ABoK4Do/blinchiki/3d печать/readme.txt

размеры 150x80x70(максимальные) leg 2 раза напечатать
