ABoK4Do/blinchiki/Финальная презентация.pptx

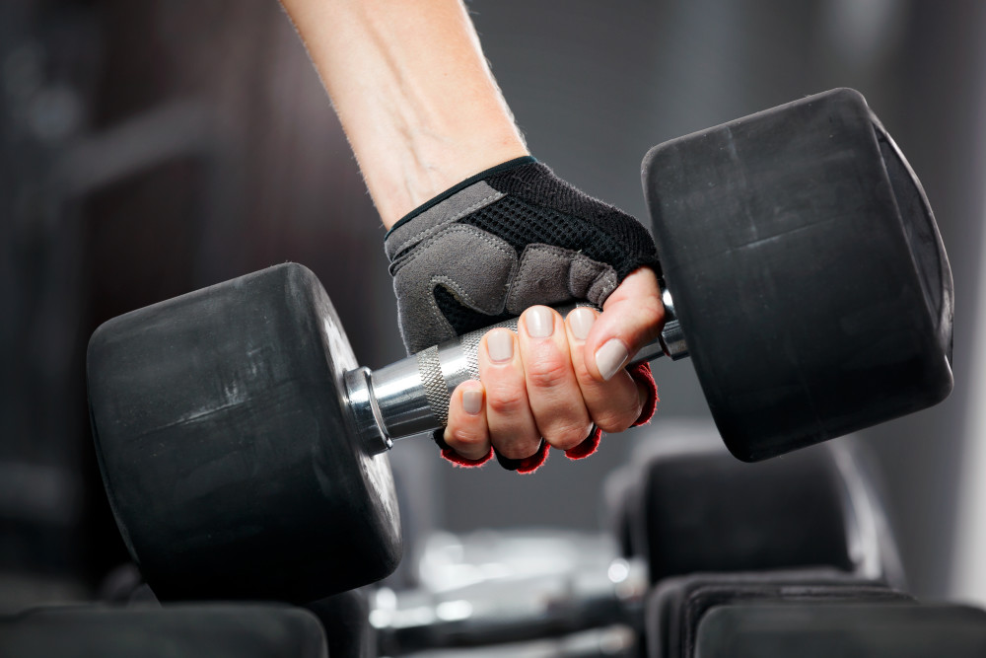
[picture p1: figure]

Brain For Barbell

## Slide 2

Резюме

Устройство

Процесс создания

Тестирование

Решением является вспомогательное устройство для гантели
Преимущества устройства включают в себя:
Контроль правильности выполнения упражнений при тренировках
Отслеживание прогресса с мобильных устройств
Сравнительно невысокая цена
Вэб интерфейс для повсеместного доступа к статистике

Определение правильности выполнения упражнение может нести вспомогательную пользу
- Повышение мотивации
- Понижение «порога входа» в спорт для людей, которым по тем или иным причинам не подходит зал

Стоит отметить, что устройство имеет как офлайн, так и онлайн функционал

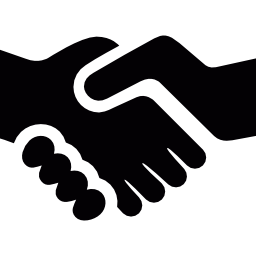
[picture p2: figure]
Hand shake
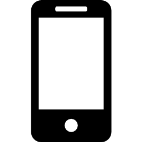
[picture p3: figure]
Cell phone
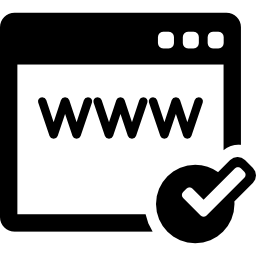
[picture p4: figure]
Domain Registration
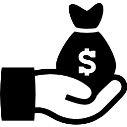
[picture p5: figure]
Dollars money bag on a hand
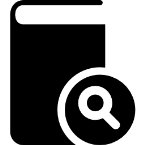
[picture p6: figure]
Book of black cover closed with a magnifier symbol on top

1. Отсчет повторов
2. Оценка результатов
3. Индикация ошибок

1. Отслеживание прогресса
2. Сравнение результатов, с иными пользователями

## Схема и пояснение конструкции устройства

Резюме

Устройство

Процесс создания

Тестирование

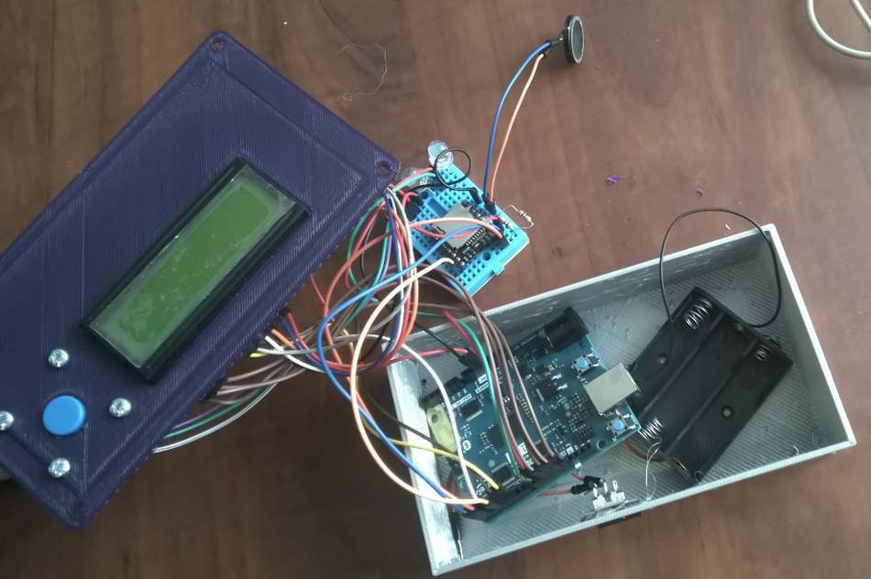
[picture p7: figure]

Дисплей

Динамик

Кнопка

Intel Genuino

Визуализация результатов

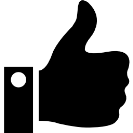
[picture p8: figure]
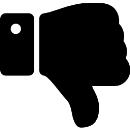
[picture p9: figure]
Thumbs down silhouette

Цена

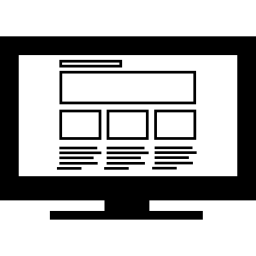
[picture p10: figure]
Responsive website design on monitor screen

Удобная поддержка

Громоздкость

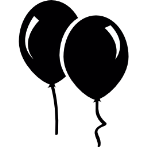
[picture p11: figure]
Floating balloons

Здесь мы говорим, что наше приложение лучше всех конкурентов ввиду его удобства, красоты и простоты. Однако во всем остальном мы проигрываем: у нас нет ни интернет-банка , ни валютных счетов. Эти удобные вещи гораздо важнее, чем какие-либо небольшие скидки, для множества людей, которые могли бы стать нашими клиентами

## Slide 4

Процесс создания

Резюме

Устройство

Тестирование

Знакомство и обсуждение

Приложение

Знакомство команды, распределение ролей, обсуждение первичного концепта устройства

Закупка

Крупные партнеры

Покупка, макетной платы, проводов, светодиодов, кнопок, динамик, хомутов и т.д.

3D моделирование необходимых деталей и программирование алгоритмов подсчета и визуализации результатов

Разработка

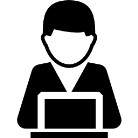
[picture p12: figure]
Shopping support online

Сборка и тестирование

CRM-анализ

Сборка прототипа и внесения изменений под влиянием новых отзывов

Веб интерфейс

CRM-анализ

Создание связи с общей сетью и интерфейса для управления через интернет

## Slide 5

Резюме

Устройство

Процесс создания

Тестирование

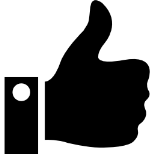
[picture p13: figure]
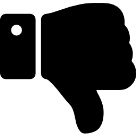
[picture p14: figure]
Thumbs down silhouette

«Я думаю крутая штука»
Удобно, если информация выводится с помощью голоса или световых индикаторов: зеленый-правильно, красный-неправильно.
Самое трудное при выполнении - заставить себя

«Я хотел бы связь тренажеров (в том числе и гантелей) с моим, скажем, аккаунтом, чтобы отслеживать прогресс, технику и т.п.»
«индикатор (цветовой например), может быть полезно"

«Бесполезная вещь»
Изучение упражнений - с помощью тренера или книг. Датчики неточные, не может заменить тренера: тренер во время выполнения щупает и видит мышцы и может подсказать как правильно
Предложение: снимать показания со всех мышц с помощью датчиков на теле

«Спину нужно определённым образом держать, думаю этот датчик бесполезен"

Выводы

  - Идея нравится
  - Метод измерения вызывает сомнения
  - Консервативное отношение к гантелям в целом
  - Дизайн не пересматриваем

Notes: Формирование предложения для партнера (с интересной для него аналитикой)

## Проект подготовила команда

Алексей Чекунин

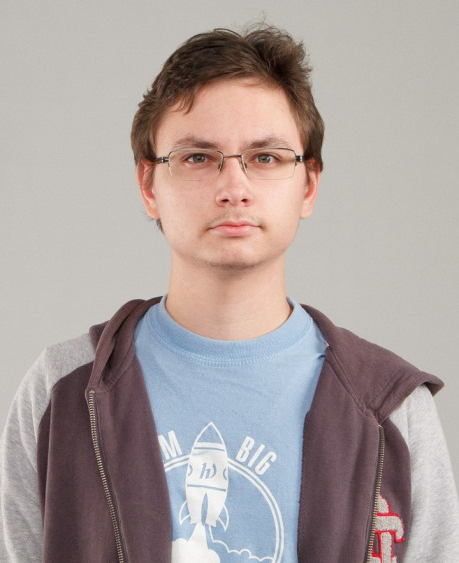
[picture p15: figure]

МФТИ

МФТИ

Антон Чердинцев

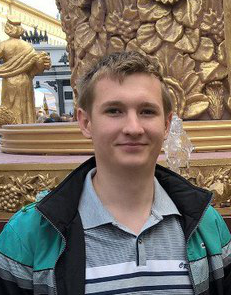
[picture p16: figure]

МФТИ

Дмитрий Харламов

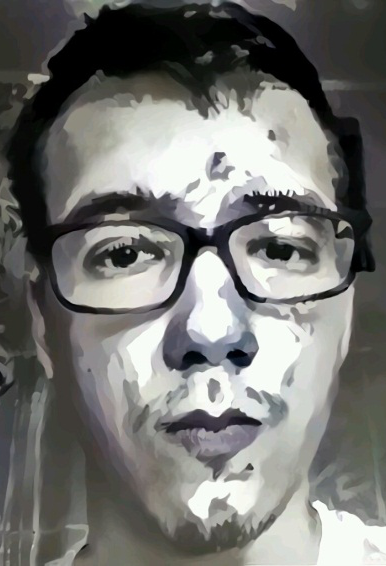
[picture p17: figure]

МФТИ

Александр Макарычев

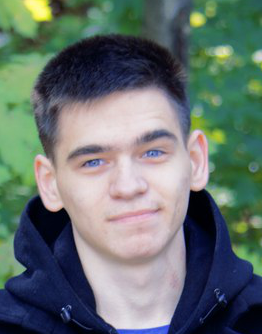
[picture p18: figure]

Финансовый университет

Научились: Программировать на Arduino, 3D-modeling(3D builder), проводить пользовательское тестирование, работать в команде, собирать схему и т.д.
