ABoK4Do/blinchiki/Опрос пользователей.pdf

# Респондент 1:

# тренер в одном из видов спорта

«Я думаю крутая штука»
Удобно, если информация выводится с помощью голоса или световых индикаторов: зеленый-правильно, красный-неправильно.
Самое трудное при выполнении - заставить себя

# Респондент 2:

## специалист технической профессии, около 50 лет, ходит в фитнес-центр

«Бесполезная вещь»
Изучение упражнений - с помощью тренера или книг Датчики неточные, не может заменить тренера: тренер во время выполнения щупает и видит мышцы и может подсказать как правильно Предложение: снимать показания со всех мышц с помощью датчиков на теле

# Респондент 3:

# занимается в спорт зале 5 лет

«Для новичков может быть актуально в процессе становления техники»
«Не заменит зал»
Есть определенная техника, которая даст эффект, отсутсвие может навредить. Статистику можно записывать в блокнот

# Респондент 4:

# студент

«Спину нужно определённым образом держать,

## думаю этот датчик бесполезен"

# Респондент 5:

# студент

«Я хотел бы связь тренажеров (в том числе и гантелей) с моим, скажем, аккаунтом, чтобы отслеживать прогресс, технику и т.п.» «индикатор (цветовой например), может быть полезно"

# Опрошено: 9 Ответили: 5 Отказались: 4

# Вывод: Большинству понравилась идея, но некоторые относились скептически к способу измерения. Дизайн устройства

решили не пересматривать.
