ABoK4Do/blinchiki/3d печать/Arduino_box13_roof_lid.stl

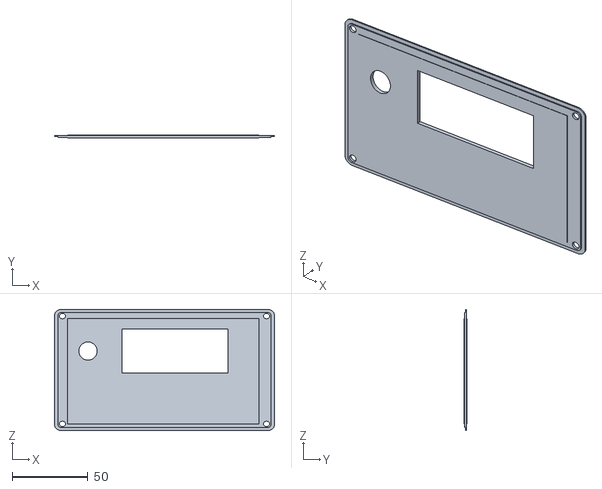
[picture p29: CAD file, 2017-02-02]
3d печать/Arduino_box13_roof_lid.stl
145.0 x 2.00 x 80.0
