ABoK4Do/blinchiki/3d печать/Arduino_box12_leg_lid.stl

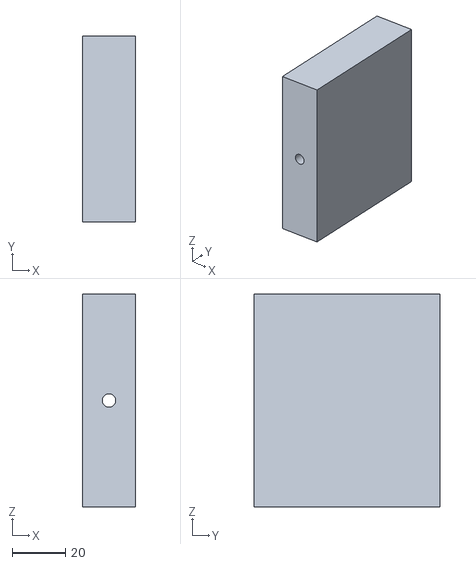
[picture p30: CAD file, 2017-02-01]
3d печать/Arduino_box12_leg_lid.stl
20.0 x 70.0 x 80.0
