ABoK4Do/blinchiki/3d печать/Arduino_box12_box_lid.stl

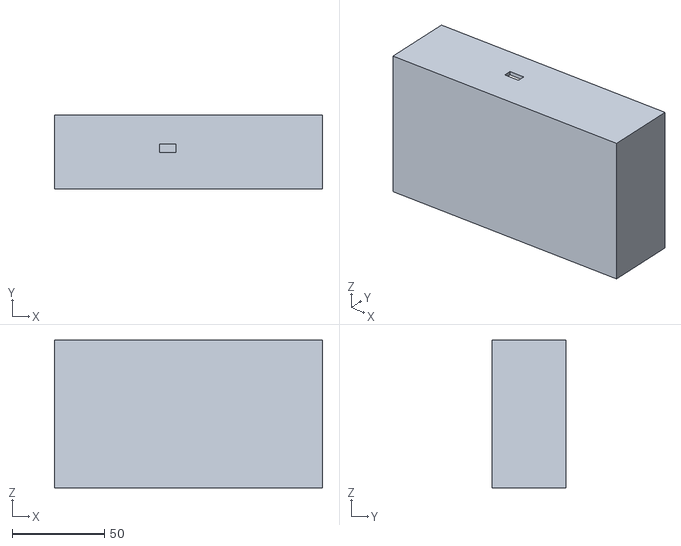
[picture p31: CAD file, 2017-02-01]
3d печать/Arduino_box12_box_lid.stl
145.0 x 40.3 x 80.0
