ABoK4Do/blinchiki/(commit log)

2017-01-31 Описание
    Мультик (фильм) о нашем продукте.
2017-01-31 upd2
    Исправлены некоторые ошибки
2017-01-31 Коробка
    [Arduino_box10new_lid.3mf, Arduino_box11new_lid.3mf]
2017-01-31 Для печати
    [Arduino_box10new_lid.3mf, Arduino_box11new_lid.3mf, Arduino_box11newnew_lid.stl]
